TMIT-Avionics/TMIT_MOTORTEST23/(commit log)

2023-11-07 Rename GroundCode.ino to Ground System/GroundCode.ino
2023-11-07 Rename MotorCode2.0.ino to Motor System/MotorCode2.0.ino
